ZeekiChen/iWatch-v2.0/HARDWARE/iWatch-v2.0-BOM.xlsx

Comment | Description | Designator | Footprint | Quantity | 参考购买链接
电容
4.7uF | 贴片陶瓷电容 | C24 | C-3216-N | 1 | https://youxin-electronic.taobao.com/category-1145410923.htm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
10uF | 贴片钽电容 | C6, C12, C18 | C-3216-N | 3
2.7pF | 贴片陶瓷电容 | C26 | C0603 | 1
22nF | 贴片陶瓷电容 | C21 | C0603 | 1
0.1uF | 贴片陶瓷电容 | C2, C5, C10, C11, C13, C14, C15, C20, C22, C27 | C0603 | 10
0.22uF | 贴片陶瓷电容 | C23 | C0603 | 1
1uF | 贴片陶瓷电容 | C8, C9, C16, C17 | C0603 | 4
10uF | 贴片陶瓷电容 | C1, C7, C19, C25 | C0603 | 4
电阻
22R | 贴片电阻，%5 | R4 | R0603 | 1 | https://youxin-electronic.taobao.com/category-1171156354.htm?search=y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
1k | 贴片电阻，%5 | R6 | R0604 | 1
2k | 贴片电阻，%5 | R2 | R0605 | 1
10k | 贴片电阻，%5 | R3, R5, R7 | R0606 | 3
560k | 贴片电阻，%5 | R1 | R0607 | 1
二极管，三极管
1N4148 | 高速开关二极管 | D1, D2, D3 | SOD-323 | 3 | https://item.taobao.com/item.htm?spm=a1z10.3-c-s.w4002-21223910208.17.51206a4bzgFUJk&id=528141270044
PMOS | P沟道场效应管 | Q1 | SOT-23 | 1 | https://item.taobao.com/item.htm?spm=a1z09.2.0.0.53ad2e8dPupKQ2&id=522554663865&_u=6b2i1bfaa23
NMOS | N沟道场效应管 | Q2 | SOT-23 | 1 | https://item.taobao.com/item.htm?spm=a1z09.2.0.0.53ad2e8dPupKQ2&id=522574089119&_u=6b2i1bf2d66
NPN | 通用NPN型三极管 | Q3 | SOT-23 | 1 | https://item.taobao.com/item.htm?spm=a1z10.3-c-s.w4002-21223910208.16.30f06a4bonYJSY&id=522577964105
集成芯片
RX8130CE | 内置晶振的RTC | U10 | RX8130CE | 1 | https://item.taobao.com/item.htm?id=670062799956&ns=1&abbucket=13 (https://item.taobao.com/item.htm?spm=a230r.1.14.32.465f21bbu0N9A6&id=670062799956&ns=1&abbucket=13)
KT6368A | 蓝牙5.1双模的纯数据芯片,同时支持SPP 和BLE | U11 | SOP8_L | 1 | https://item.taobao.com/item.htm?spm=a1z09.2.0.0.53ad2e8dPupKQ2&id=630430098226&_u=6b2i1bfec20
CH340E | USB转串口，免外部晶振，超小封装 | U4 | MSOP10 | 1 | https://item.taobao.com/item.htm?id=647080743664&ali_trackid=1_74a01fd8bc625218c4d48282426d3b16
GT20L16S1Y | 字库芯片 | U5 | SOT23-6L | 1 | https://item.taobao.com/item.htm?spm=a1z09.2.0.0.53ad2e8dPupKQ2&id=631889600682&_u=6b2i1bf0540
XT4054 | 锂电池充电ic | U7 | SOT23-5 | 1 | https://item.taobao.com/item.htm?spm=a1z09.2.0.0.53ad2e8dPupKQ2&id=533845076633&_u=6b2i1bf0956
RT9193-33GB | LDO-3.3v | U8 | SOT23-5 | 1 | https://item.taobao.com/item.htm?spm=a1z10.3-c-s.w4002-21223910208.10.63116a4bKRfpyx&id=522574021262
LSM6DSM | always-on 3D accelerometer and 3D gyroscope | U2 | LGA-14L | 1 | https://item.taobao.com/item.htm?id=592155615422&ns=1&abbucket=13 (https://item.taobao.com/item.htm?spm=a230r.1.14.69.78142030pZyDnp&id=592155615422&ns=1&abbucket=13)
HDC2080 | TI/温湿度传感器 | U9 | DFN-6 | 1 | https://item.taobao.com/item.htm?spm=a1z10.3-c-s.w4002-24015393012.15.170046e9FiwGiU&id=620769435833
QMC5883L | 高精度三轴磁力计 | U6 | QFN16 3X3 | 1 | https://item.taobao.com/item.htm?spm=a1z10.3-c-s.w4002-23675134154.9.63976bb5d4j4Jn&id=673277266026
BMP390 | 博世高精度气压传感器 | U3 | LGA-10 | 1 | https://item.taobao.com/item.htm?spm=a1z10.5-c-s.w4002-22970662294.17.6fd438d37flsy7&id=660486238889
STC32G12K128 | 增强型51单片机 | U1 | LQFP48 7X7_L | 1 | https://item.taobao.com/item.htm?spm=a1z10.3-c-s.w4002-21223910208.43.44306a4bIfLGeP&id=670800520925
晶振
24Mhz | 贴片晶振,24Mhz,10ppm | Y2 | 2025-4P | 1 | https://item.taobao.com/item.htm?spm=a1z09.2.0.0.73a62e8dKcTXUu&id=615178098552&_u=6b2i1bf9c06
天线
ANT | OA-C07 单极 小尺寸PCB板载2.4G天线 | ANT1 | 2.4GANT-3216 | 1 | https://item.taobao.com/item.htm?spm=a1z09.2.0.0.53ad2e8dPupKQ2&id=627328734225&_u=6b2i1bfe56c
蜂鸣器
Buzzer | 贴片蜂鸣器 | B1 | SMD402 | 1 | https://item.taobao.com/item.htm?spm=a1z09.2.0.0.209b2e8dpU4tRH&id=633598764121&_u=5b2i1bf4645
按键，开关
SS-12F23 | 单刀双掷开关 | S1 | MK-12C02 | 1 | https://item.taobao.com/item.htm?spm=a1z09.2.0.0.53ad2e8dPupKQ2&id=540403278241&_u=6b2i1bf69a0
Button | 轻触开关 | SW1, SW2, SW3, SW4 | TSW SMD-2*4*3.5 | 4 | https://item.taobao.com/item.htm?spm=a1z10.3-c-s.w4002-21223910208.34.84b36a4b7QK7kB&id=546690284515
接口
USB-C | USB-C型母接口 | USB1 | USB-C-SMD_16P | 1 | https://item.taobao.com/item.htm?spm=a1z09.2.0.0.73a62e8dKcTXUu&id=573090887123&_u=6b2i1bfcff0
屏幕
1.3"-128*64OLED | OLED12864屏幕 | OLED1 | OLED-1.3-90 | 1 | https://item.taobao.com/item.htm?spm=a1z0d.6639537.1997196601.341.4e6c7484OAJLMG&id=601041736707
电池
Battery | 3.7v,200mAh,40*25*25mm |  | 402525 | 1 | https://item.taobao.com/item.htm?spm=a1z0d.6639537.1997196601.14.fd907484RuDoP0&id=619951446947
表带
表带 | 宽度：20mm，颜色：自选 |  |  | 1 | https://item.taobao.com/item.htm?spm=a1z09.2.0.0.501a2e8deNibhL&id=621340659994&_u=ab2i1bf5113
外壳
手表主外壳 | 3D文件见附件，使用光固化打印 |  |  | 1 | 光固化打印可去未来工厂或者三维猴等平台打印
手表外壳后盖 | 3D文件见附件，使用光固化打印 |  |  | 1
备选 |  |  |  |  | HDC2080价格浮动比较大，如遇价格太高的时候，可使用下面两个传感器替换，修改驱动程序即可
HDC1080 | 温湿度传感器 | U9 | DFN-6 | 1 | https://item.taobao.com/item.htm?spm=a1z10.3-c-s.w4002-21223910208.50.3c016a4bqXvAYv&id=673541472220
HTU21D | 温湿度传感器 | U9 | DFN-6 | 1 | https://item.taobao.com/item.htm?id=536704322822&ns=1&abbucket=13 (https://item.taobao.com/item.htm?spm=a230r.1.14.6.694f73d9fP4628&id=536704322822&ns=1&abbucket=13)
