ZeekiChen/iWatch-v2.0/3DModel/11手表壳.STL

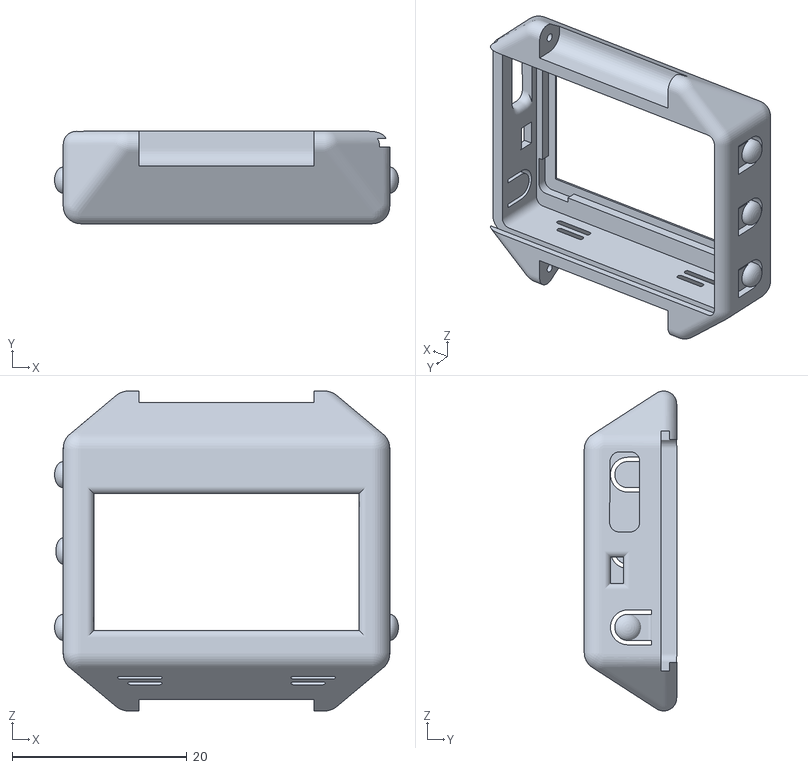
[picture p21: CAD file, 2022-05-26]
3DModel/11手表壳.STL
39.4 x 10.6 x 36.7
