ZeekiChen/iWatch-v2.0/3DModel/12手表壳后盖.STL

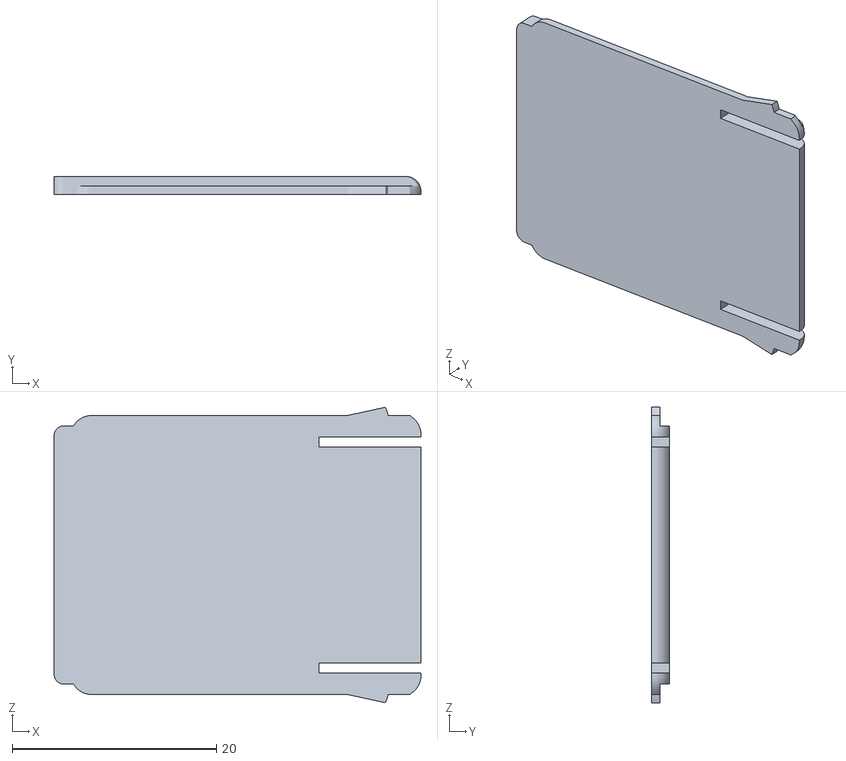
[picture p22: CAD file, 2022-05-26]
3DModel/12手表壳后盖.STL
35.9 x 1.80 x 28.9
