ZeekiChen/iWatch-v2.0/HARDWARE/iWatch-v2.0-丝印图.pdf

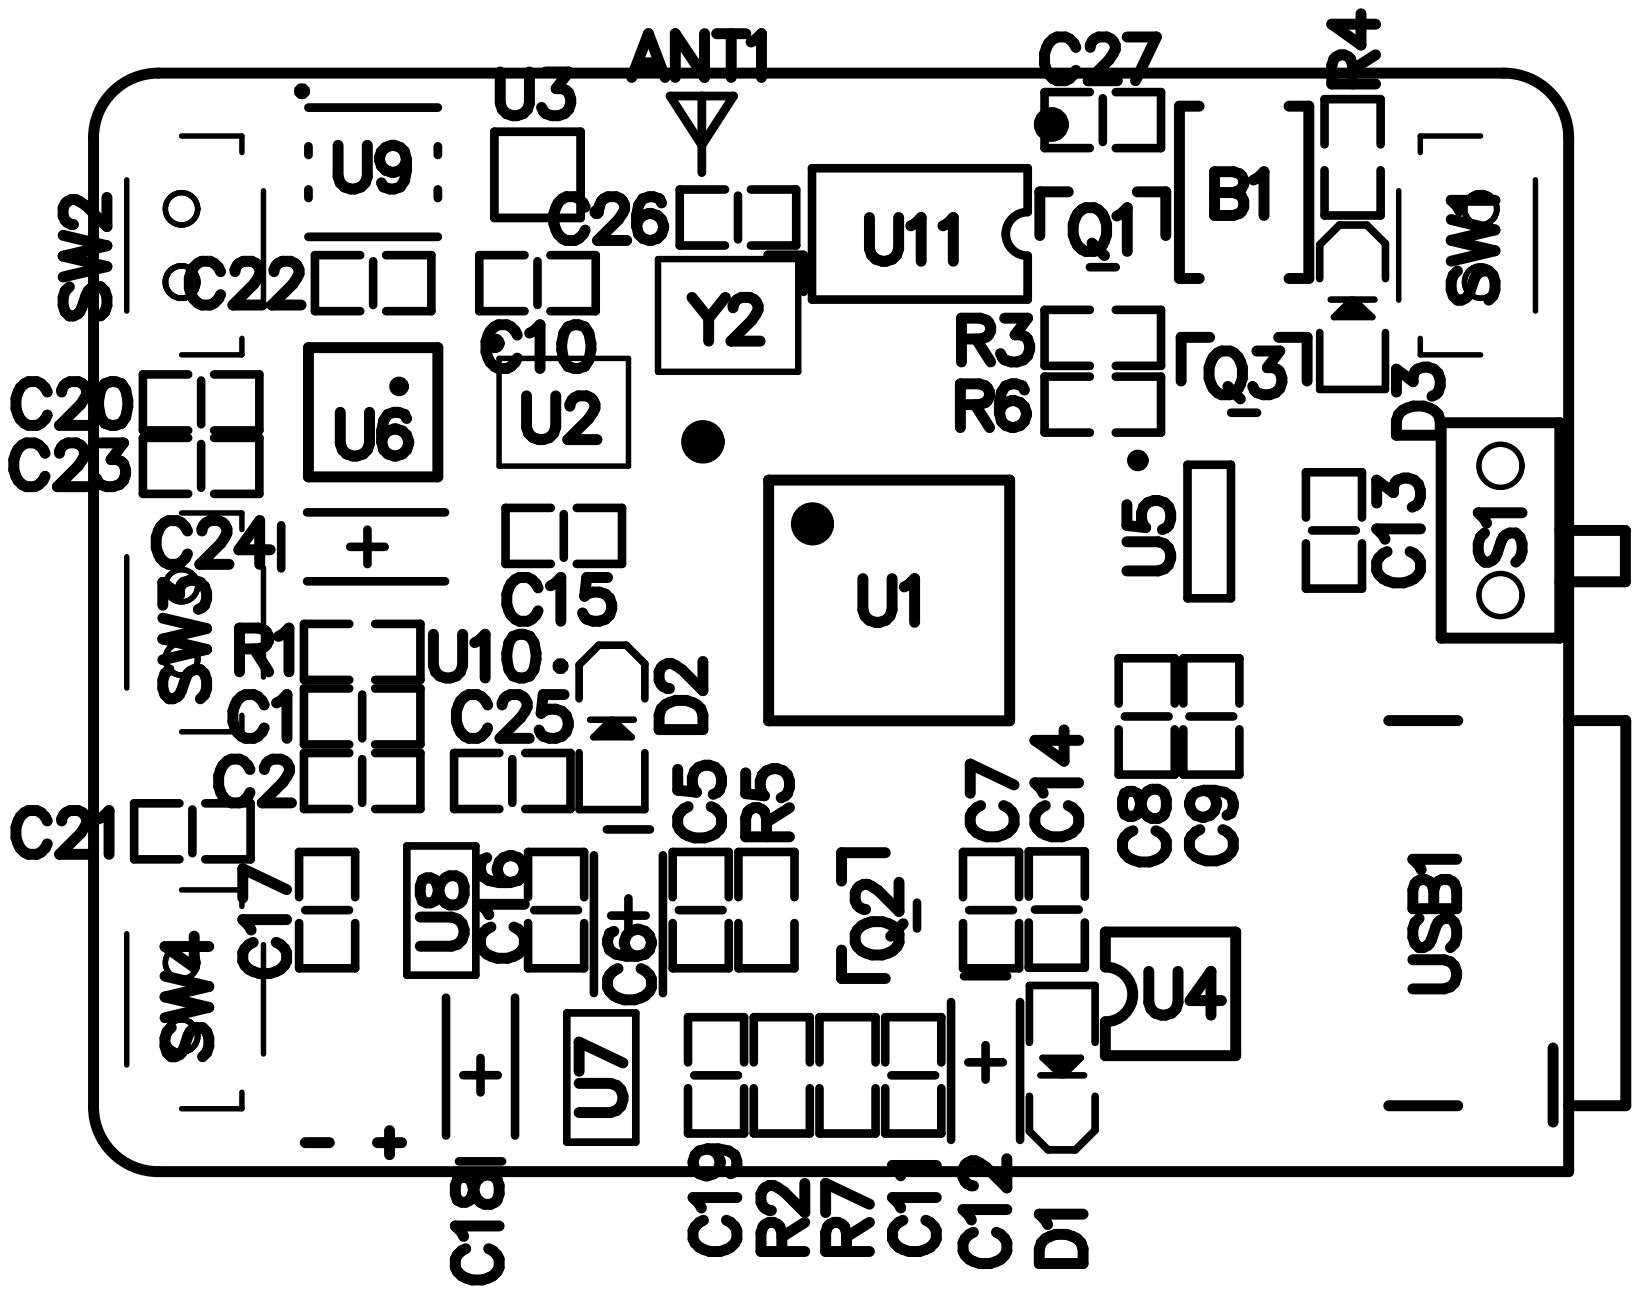
[picture p23: page 1]
