ZeekiChen/iWatch-v2.0/HARDWARE/iWatch-v2.0-SchDoc.pdf

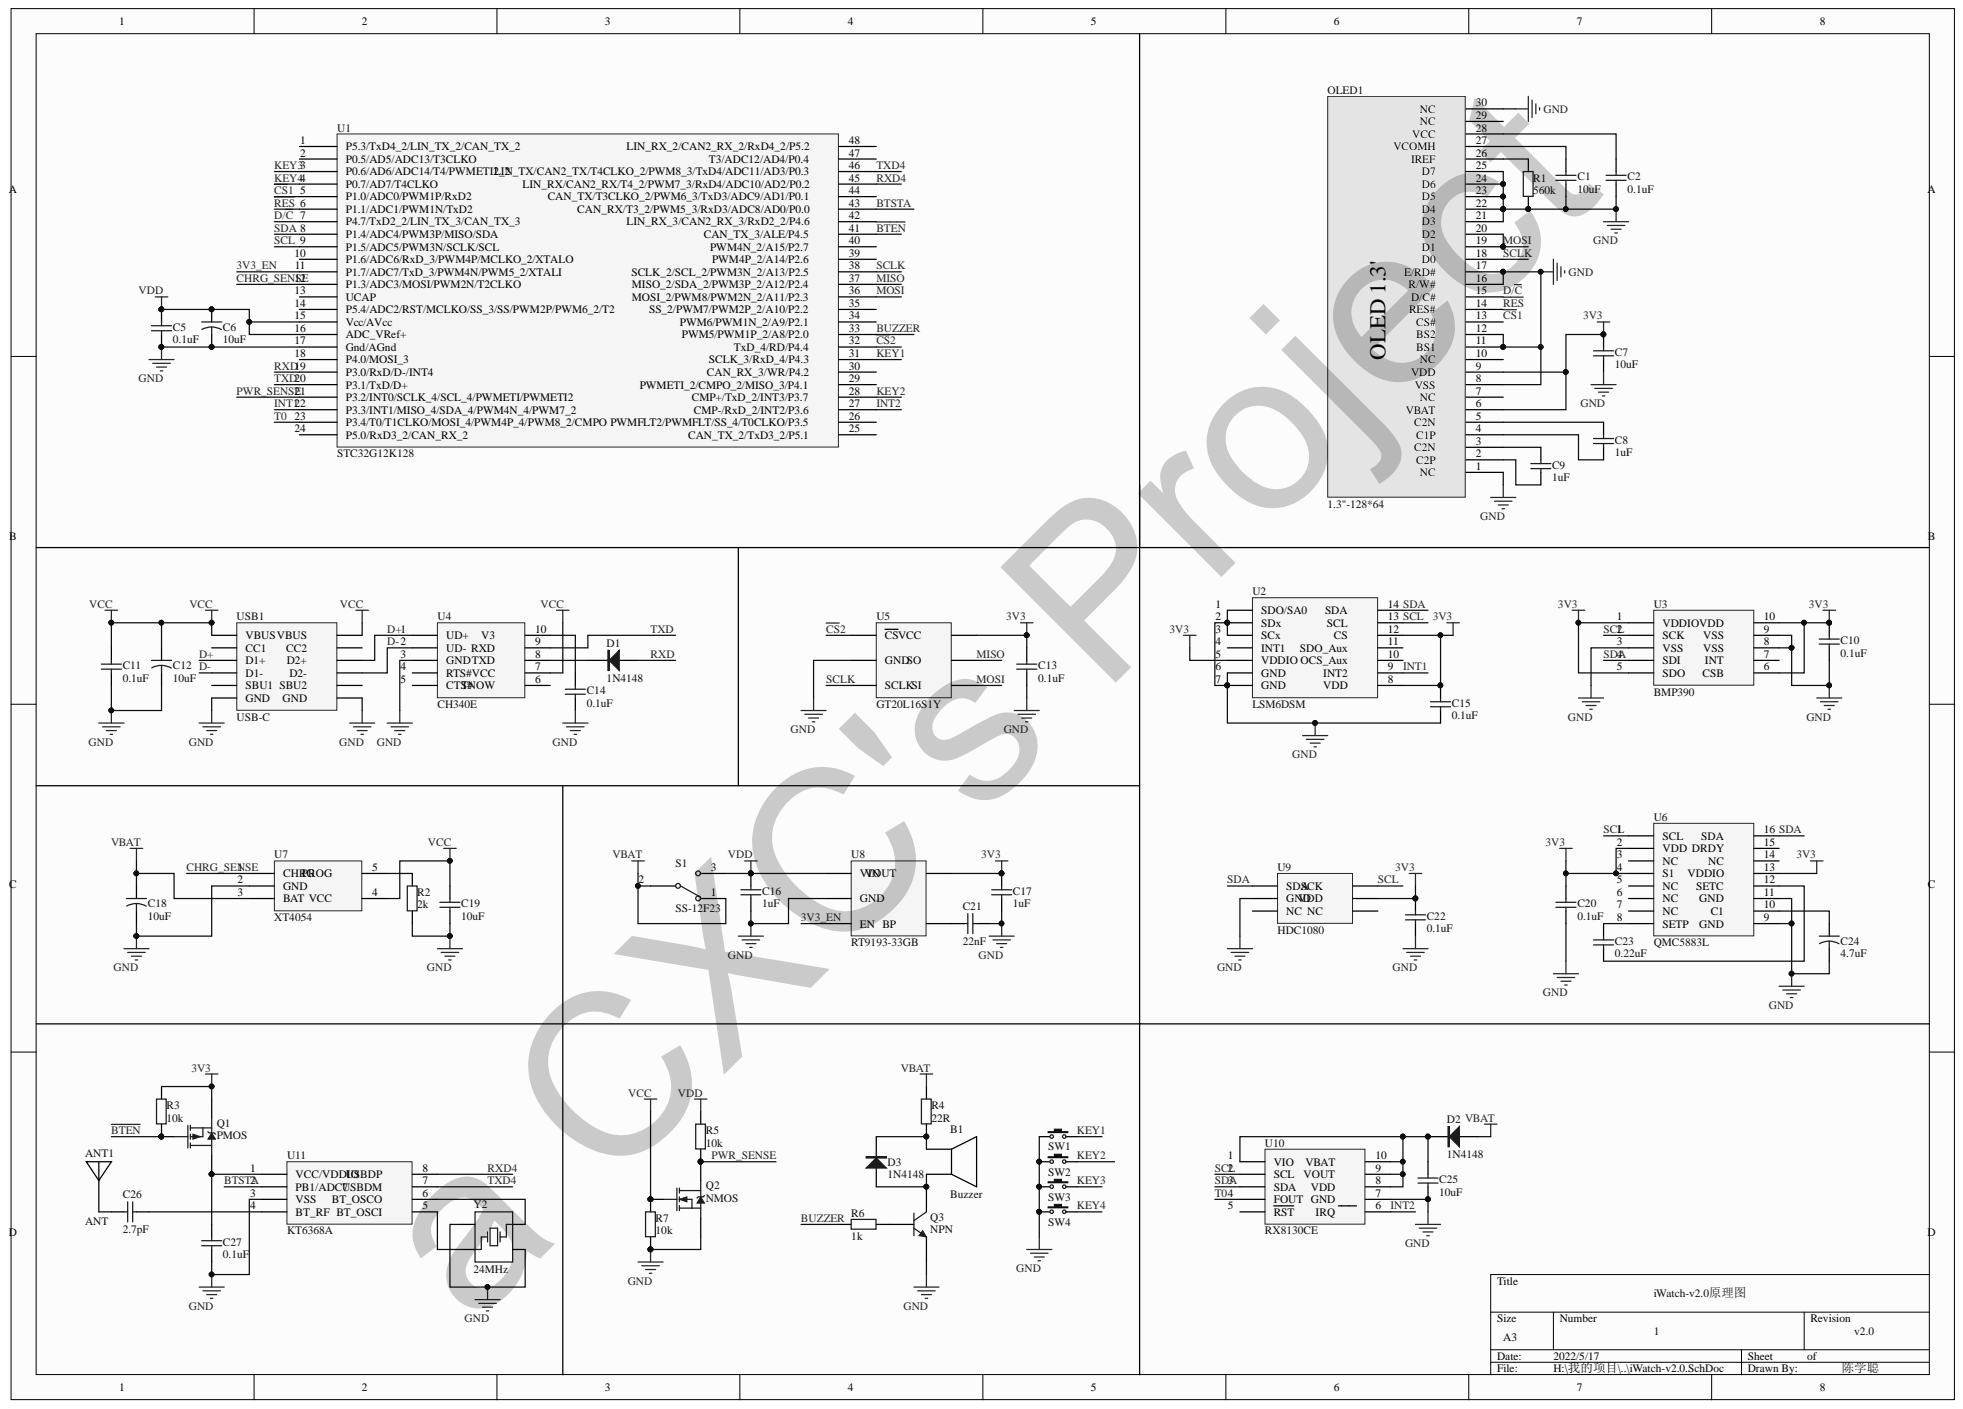
[picture p24: page 1]
